adafruit/Adafruit-Infrared-IR-Remote-Transceiver/Adafruit Infrared IR Remote Transceiver.brd

## EAGLE design Adafruit Infrared IR Remote Transceiver.brd (2024-07-08)

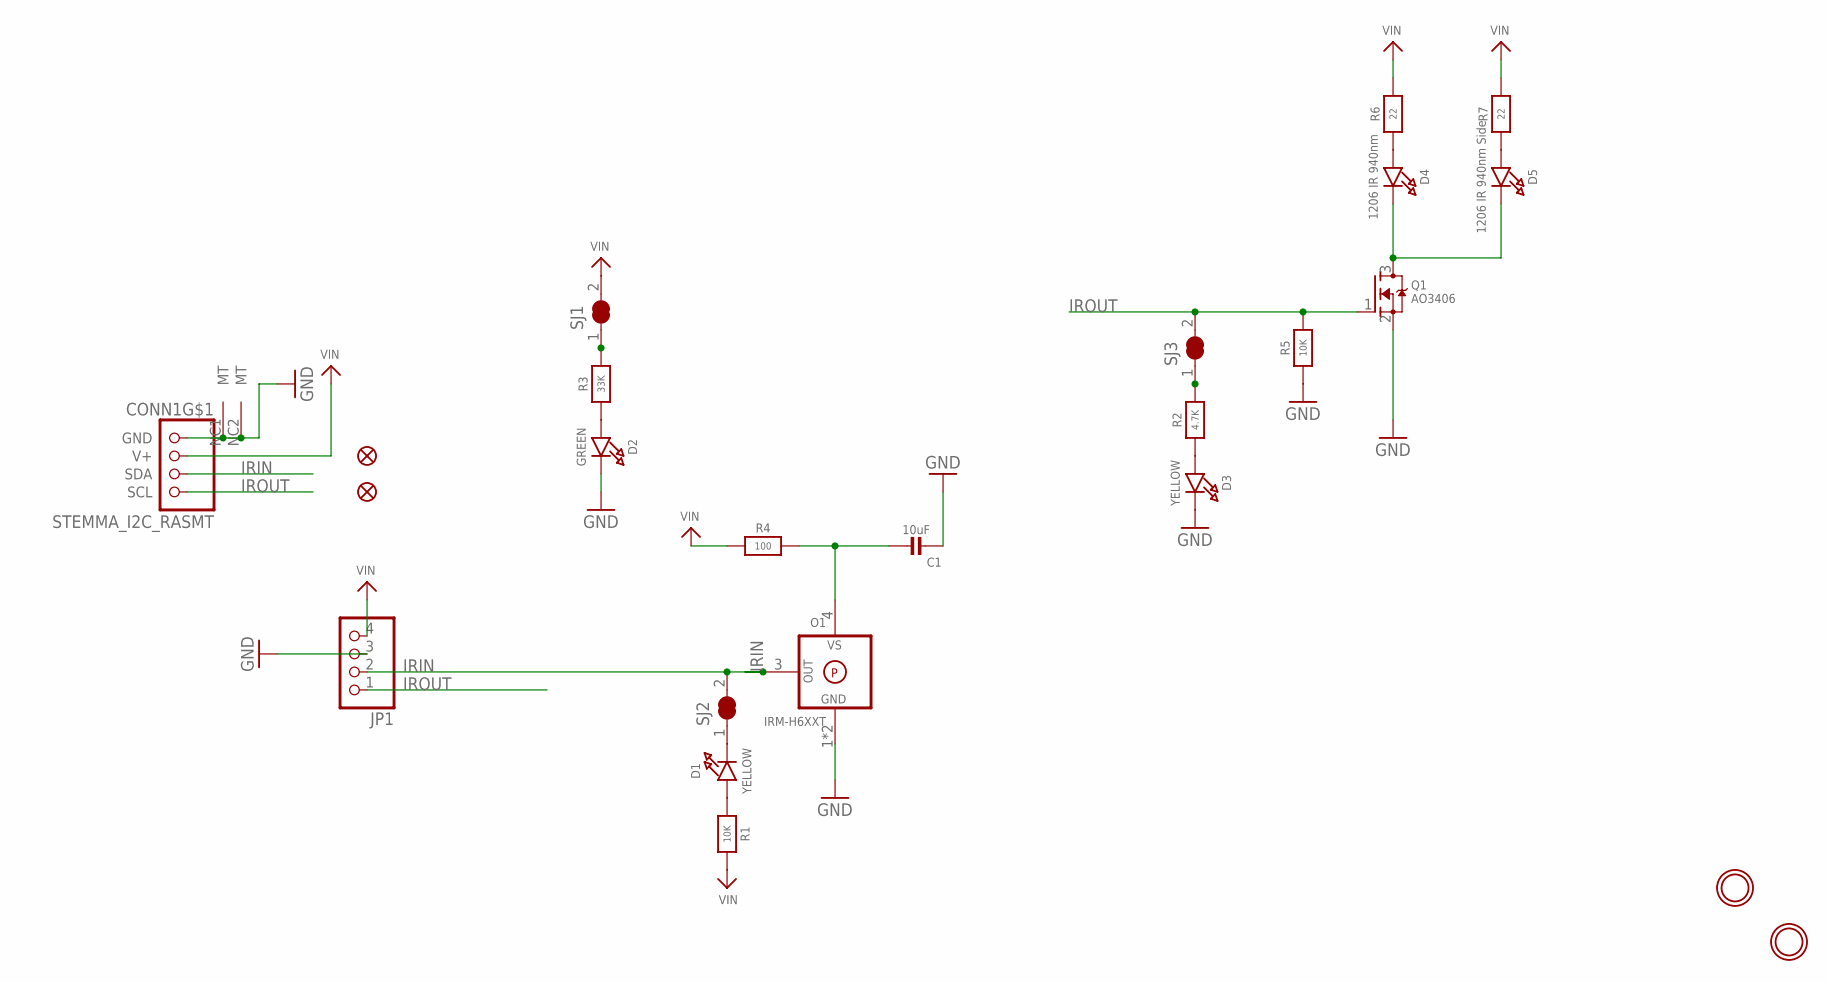
[picture p2: schematic Adafruit Infrared IR Remote Transceiver.sch]

Parts:
C1: 10uF; 0805-NO
CONN1: STEMMA_I2C_RASMT; JSTPH4
D1, D3: YELLOW; CHIPLED_0603_NOOUTLINE
D2: GREEN; CHIPLED_0603_NOOUTLINE
D4: 1206 IR 940nm; CHIPLED_1206
D5: 1206 IR 940nm Side; LED_1206_SIDE
FID2, FID3: FIDUCIAL_1MM
JP1: HEADER-1X476MIL; 1X04_ROUND_76
O1: IRM-H6XXT
Q1: AO3406; SOT23-WIDE
R1, R5: 10K; 0603-NO
R2: 4.7K; 0603-NO
R3: 33K; 0603-NO
R4: 100; 0603-NO
R6, R7: 22; 0603-NO
SJ1, SJ2, SJ3: SOLDERJUMPER_CLOSED; SOLDERJUMPER_CLOSEDWIRE
U$1, U$8: MOUNTINGHOLE2.5; MOUNTINGHOLE_2.5_PLATED

Connections:
GND: C1.2, CONN1.1 (GND), CONN1.NC1 (MT), CONN1.NC2 (MT), D2.C, D3.C, JP1.3, O1.1 (GND), O1.2 (GND), Q1.2 (S), R5.1
IRIN: CONN1.3 (SDA), JP1.2, O1.3 (OUT), SJ2.2
IROUT: CONN1.4 (SCL), JP1.1, Q1.1 (G), R5.2, SJ3.2
unnamed: R3.2, SJ1.1
unnamed: D1.A, R1.1
unnamed: D1.C, SJ2.1
unnamed: C1.1, O1.4 (VS), R4.2
unnamed: R2.2, SJ3.1
unnamed: D3.A, R2.1
unnamed: D4.C, D5.C, Q1.3 (D)
unnamed: D4.A, R6.1
unnamed: D5.A, R7.1
unnamed: D2.A, R3.1
VIN: CONN1.2 (V+), JP1.4, R1.2, R4.1, R6.2, R7.2, SJ1.2

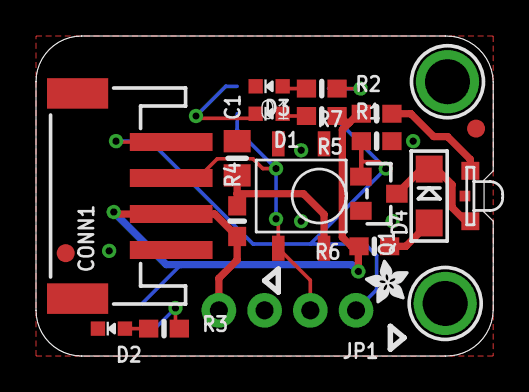
[picture p3: board Adafruit Infrared IR Remote Transceiver.brd from above]

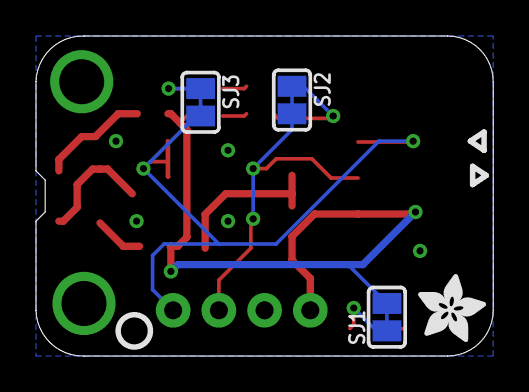
[picture p4: board Adafruit Infrared IR Remote Transceiver.brd from below]

Board: 2 copper layers, 25.4 x 17.8 mm, 45 parts (15 on the bottom side), 14 nets.

Other parts of the board:
PLABEL0: PLABEL0
PLABEL1: PLABEL1
PLABEL2: PLABEL2
PLABEL3: PLABEL3
PLABEL4: PLABEL4
PLABEL5: PLABEL5
PLABEL6: PLABEL6
PLABEL7: PLABEL7
PLABEL8: PLABEL8
PLABEL9: PLABEL9
PLABEL10: PLABEL10
PLABEL11: PLABEL11
PLABEL12: PLABEL12
PLABEL13: PLABEL13
PLABEL14: PLABEL14
PLABEL15: PLABEL15
PLABEL16: PLABEL16
PLABEL17: PLABEL17
U$5: PCBFEAT-REV-040
U$12: ADAFRUIT_3.5MM
U$13: ADAFRUIT_2.5MM
